Geraffel-Village/Beernary/README

# b33rn4rycounter
B33rn4ry Counter v2 by GeraffelVillage

https://wiki.geraffel-village.de/doku.php?id=geraffel:b33rn4ry

## Hardware V1
* based on a Atmel uC
* written is assembler

## Hardware V2
* based on RaspberryPi
* written in python
* operation separated into 2 functional boxes:
  * counter "counting and accesscontrol" (connected to the draught beer dispenser)
  * registry / cashier (Qt-Gui)
