Geraffel-Village/Beernary/pcb-design/README.md

# b33rn4ryCounter PCB

Printed circuit board for the b33rn4ry counter.

PCB
