Geraffel-Village/Beernary/beernary/interface/deleteUser.png

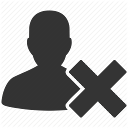
beernary/interface/deleteUser.png
