Geraffel-Village/Beernary/beernary/interface/exit.png

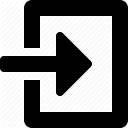
beernary/interface/exit.png
