Geraffel-Village/Beernary/beernary/interface/newUser.png

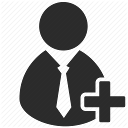
beernary/interface/newUser.png
