Geraffel-Village/Beernary/beernary/interface/refresh.png

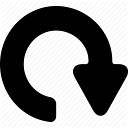
beernary/interface/refresh.png
