Geraffel-Village/Beernary/pcb-design/b33rn4ryCounterPCB.png

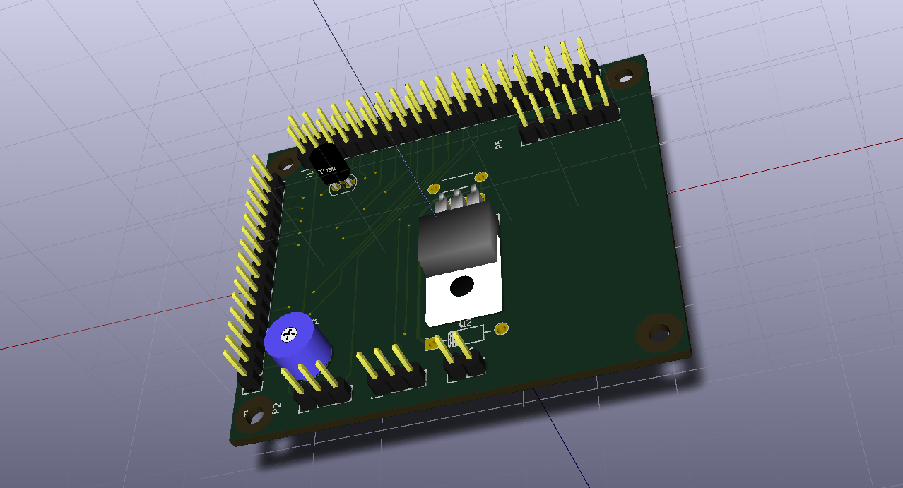
pcb-design/b33rn4ryCounterPCB.png
