Geraffel-Village/Beernary/(threads)

Thread 2 (2015-10-04):

add some local controls of operation

SvenRoederer, 2015-10-04:
Think it would be nice to have some buttons to change the keg without the need of a PC

SvenRoederer, 2019-07-27:
@MicDiFebo is this a feature you referenced by "Kür"?

MicDiFebo, 2019-07-29:
Ack, I was thinking about having a reminiscence to the classical BC, where we had 4 buttons for basic operations directly on the device. That were Up, Down, Enter, Escape/Back. Thats all we need.

SvenRoederer, 2019-07-30:
Do we have such 4-way control? What about an encoder  (turn left, turn right, press button)?

What functions do we want to control?

MicDiFebo, 2019-07-30:
Encoder sounds good - a pushwheel, push = Enter for example. Needs one more back-button.
I have some in my Geraffel-Kiste....:-)

SvenRoederer, 2019-07-30:
We can also use a "back" menuitem or a "longpress" return feature.

SvenRoederer, 2019-07-30:
But I'm really unsure, if we can reliable decode the Encoder and it's operation and in parallel doing reliable counting of pulses (see issue #5).

MicDiFebo, 2019-07-30:
We should do it like in a car where you also (normally) cannot edit the setup-parameters while driving. Meaning that local control elements should be blocked while drafting beer.

SvenRoederer, 2023-08-07:
As an potential alternative to the Encoder I got a Adafruit 12-channel touch-sensor (https://www.adafruit.com/product/1982)

Thread 3 (2015-10-04):

some emergency power-source

SvenRoederer, 2015-10-04:
to get a beer even when there is no mains

MicDiFebo, 2019-07-30:
The first and very simply USV only consists of a battery looped in the powerline. That would keep the BC running for hours, but it is not possible to open the valve with that construction.

SvenRoederer, 2019-07-31:
Not sure if a small solid car-battery is an option for the valve (or 2 6V motorcycle batteries)

MicDiFebo, 2019-07-31:
Surely that will work, but that is much too big for our enclosure. :-)
In General we can think of using a 3cell lipo-battery like it is used in RC-modells (I used this in my Heli- and Quadcopter), but then we need a separat charging-electronic, which is a bit more complex for 3cells, because they must be balanced during charging.

SvenRoederer, 2019-08-01:
at the end, we can just replace the wallwart (isn't it 12V DC) by a external battery, just by repluging. As the Pi will keep running by the mentioned USB-type UPS a short moment w/o external power is fully acceptable.
Something like [this 12V 5Ah-type](https://www.reichelt.de/blei-vlies-akku-12-v-5-ah-wp-5-12e-f2-p202385.html?) might be enough and we can charge by a regular bench supply.

SvenRoederer, 2019-08-01:
We should also keep in mind, that w/o mains, the cooler will not run and only a limited amount of fluid can be drafted "corrrectly". So there is only a limited duration we should be able to draft w/o mains, e.g. 1h / 5l beer.

Thread 5 (2019-07-03):

counting of pluses from flowmeter seems unreliable

SvenRoederer, 2019-07-03:
During the last event I found that the same size kegs have very different total number of counts. This leads to an unusable prediction of the fill-level.

I assume, this is caused by the counting-code of the RPi-software. As far as I remember it's using "poll"-mode for the pulses. It's quite realistic that the pulse-frequency is to high or the gpio-lib to slow. Currently we are using https://pypi.org/project/RPi.GPIO/

Options to fix this:
* find a better library
* use a dedicated counting-circuit

MicDiFebo, 2019-07-14:
Beernary counting should be based on realtime-interrupt-counting like it was on our prototype with an Atmel µC. The pulse frequency of the counting device itselve is not really high - as far as I remember we have 171 pulses per liter. Even if you would leave the tap open for a minute and beer is floating constantly i guess you will only have about 10 liters. That means 1710 pulses/minute or 28,5 Hz - not very high ;-)

SvenRoederer, 2019-07-14:
As of the low frequency the effect of a missing pulse is roughly 6ml, only.
But have a reliable counting again a "realtime-interrupt-counting" seems the best option for now. Adding some µC for this which :
* counts pulses on one end
* talks to the RPi on the other end via serial-port
seems to be enough.

Serial communication should at least have two commands:
* "getcount" - returns the number of counted pulses (unsigned int)
* "resetcount" - resets the counter to 0

Having this installed we can still have the RPi-counting connected on parallel and compare the difference of counted pulses and try to improve the RPi-code

SvenRoederer, 2019-07-20:
As discussed on chat, the serial port of the RPi is planned for the serial RFID reader (see PR #6). So a regular serial (rs232 like) connection is not possible. I see following options:
* adding a 2nd serial port of the RPi (USB <--> serial; probably there is some driver "GPIO <---> rs232" around)
* using RS485 to build a serial-bus with RPi, Reader and Counter-chip)
* finding a I2C or SPI counter chip (I had no luck with this)
* adding an SPI / I2C interface to the counting-controller

SvenRoederer, 2022-07-31:
During MCH2022 I installed a small Arduino to count the pulses in parallel to the RPi. It's connected to the RPi via USB (cable looped out to the external USB-ports) for power and serial-interface.

Thread 14 (2019-08-21):

format of RFID-TagID

SvenRoederer, 2019-08-21:
The USB-reader sends a "^D" as first char of RFID, which is also sent into the database.

> INSERT INTO `users` VALUES
> ('^D03004A789','test','2019-08-15 14:50:43'),('^D2F00BF864','mic','2019-08-15 14:51:18')

SvenRoederer, 2019-08-21:
just checked again:
**USB-reader @ Registry:**
* TagID (printed on Tag 0012550099) is stored in DB as "2F00BF7FD3"
* TagID(printed on Tag 0013252798) is stored in DB as "3800CA38BE"
* TagID(nothing printed on) is stored as "03004A7893"

readding the Tags via B33rn4ryRegistry did not insert them with "^D" prefix ???

ziehmon, 2023-07-19:
Seems resolved via #15

Closed 2023-07-19.

Thread 16 (2019-08-21):

fatal fail when "none" id is in Database

SvenRoederer, 2019-08-21:
@MicDiFebo made it to add the following record into the database:

```
+----------+-------------------+---------------------+
| id       | name              | timestamp           |
+----------+-------------------+---------------------+
| None     | Mic               | 2019-08-21 17:26:25 |
```

this caused a fatal excetion on startup of registry:

> pi@b33rnary-c0unter:/home/b33rnary-c0unt3r/b33rn4rycounter $ ./B33rn4ryRegistry.py
Traceback (most recent call last):
  File "./B33rn4ryRegistry.py", line 200, in <module>
    window.refreshUserTable()
  File "./B33rn4ryRegistry.py", line 68, in refreshUserTable
    pID = str(int(row[0][2:], 16))
ValueError: invalid literal for int() with base 16: 'ne'

Thread 18 (2022-07-29):

transfer repo to new GitHub-organization "Geraffel-Village"

SvenRoederer, 2022-07-29:
During MCH2022 @sp3t3rs created @geraffel-village organization, to allow having a common place for all Geraffel-Village projects.
Can you transfer the ownership of this repo to the organization (Settings-menu --> transfer ownership). This way we can preserve the current Issues, PRs (and wiki-pages).

phl0, 2022-07-29:
Will so.

phl0, 2022-07-29:
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

phl0, 2022-07-29:
Can we safely delete that fork?

SvenRoederer, 2022-07-29:
I moved it beside and will take care of removal then.

phl0, 2022-07-30:
done. Welcome Geraffel

Closed 2022-07-30.

Thread 19 (2022-07-30):

Add systemd service script as init.d replacement

SvenRoederer, 2022-07-30:
during MCH2022 the OS was upgraded to Raspberry Pi OS based on Debian 11 (bullseye).
For optimal support we should include a script to start the b33rn4rycounter as a systemd-service.

ziehmon, 2023-07-22:
Implemented in #23  :heavy_check_mark:

Closed 2023-07-22.

Thread 24 (2023-07-23):

Refactor class capsulation, nesting and interfacing

ziehmon, 2023-07-23:
Currently, the implementation is not fully object-oriented. We're missing full object-based implementation for
  - `beernary_lcd.py`
  - `beernary_configuration.py`

Further more,  `beernary_lcd.py` is required to be abstracted from hardware in case of changes, like implemented in `beernary_database`. This can help handling `LCD_LINES` and `STDOUT`-forwarding too.

Also, `UsbRfid` and `SerialRfid` in `beernary_reader.py` could be implemented via a common object and specific characteristics could be overloaded instead of having to classes.

For all code, modules **and** implementation in `beernary_counter.py` and `beernary_registry.py`, proper encapsulation and reusability needs to be restored.

ziehmon, 2023-08-14:
Implemented via #27

Closed 2023-08-14.

Thread 30 (2023-08-16):

Danke für das Sektfrühstück

Orilcious, 2023-08-16:
... devalidiert mal die test credentials unter deployment/ansible/roles/beernary-database/files/beernary-ccc2023.sql

:upside_down_face:

ziehmon, 2023-08-16:
Danke für den Hinweis, der Tag wurde aus der Datenbank entfernt (`beernary-ccc2023.sql` wird sowieso nicht mehr geupdated, dass war ein initialer Datensatz).

Es ist natürlich bekannt das man RFID tags jederzeit clonen kann. Insofern sei dir dein Freisekt gegönnt - works as designed :)

ziehmon, 2023-08-16:
Und: happy first issue :)

Closed 2023-08-16.
