Geraffel-Village/Beernary/pcb-design/b33rn4ryCounterPCB.kicad_pcb

## KiCad design pcb-design/b33rn4ryCounterPCB.kicad_pcb (2023-08-12)

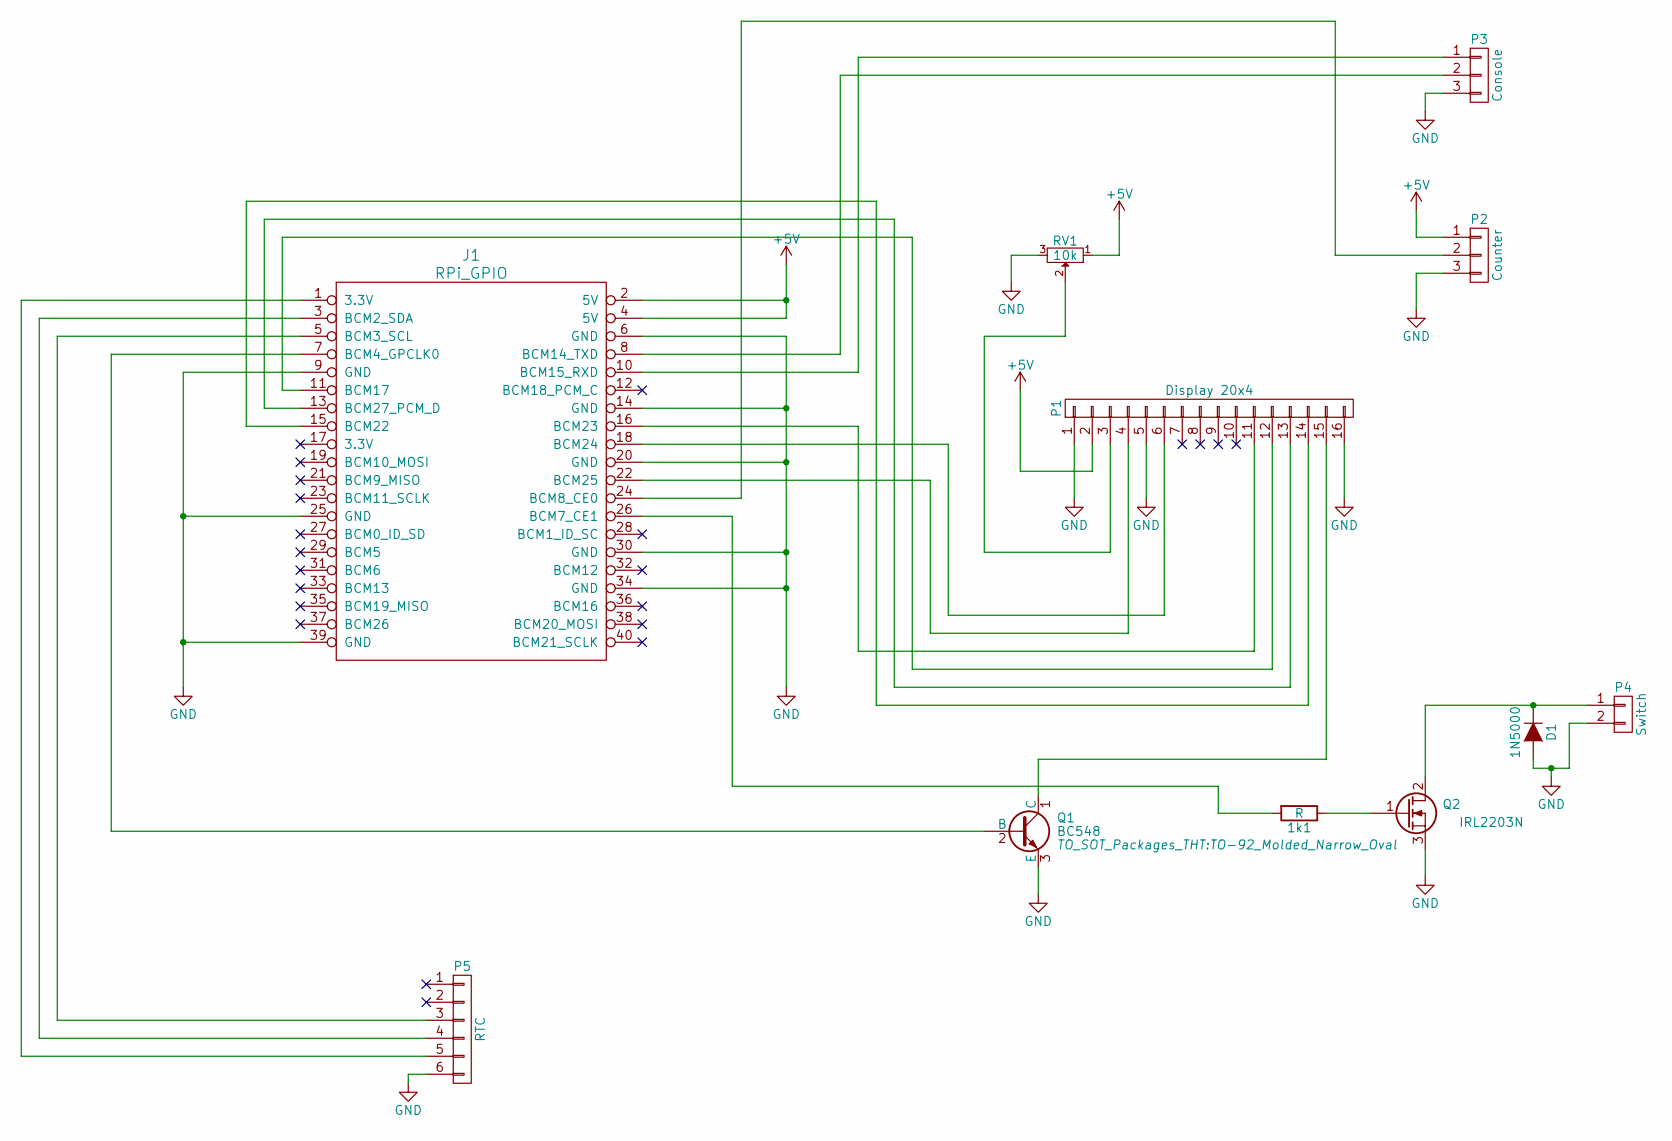
[picture p9: schematic b33rn4ryCounterPCB.sch]

Parts:
1k1: R; Resistor_Horizontal_RM7mm
D1: 1N5000; Diode_DO-41_SOD81_Horizontal_RM10
J1: RPi_GPIO; Pin_Header_Straight_2x20
P1: Display 20x4; Pin_Header_Angled_1x16
P2: Counter; Pin_Header_Straight_1x03
P3: Console; Pin_Header_Straight_1x03
P4: Switch; Pin_Header_Straight_1x02
P5: RTC; Pin_Header_Straight_1x06
Q1: BC548; TO-92_Molded_Narrow_Oval
Q2: IRL2203N; TO-220_Neutral123_Horizontal
RV1: 10k; Potentiometer_Bourns_3339P_Angular_ScrewUp

Connections:
+5V: J1.2 (5V), J1.4 (5V), P1.2, P2.1, RV1.1
GND: D1.2 (A), J1.6 (GND), J1.9 (GND), J1.14 (GND), J1.20 (GND), J1.25 (GND), J1.30 (GND), J1.34 (GND), J1.39 (GND), P1.1, P1.5, P1.16, P2.3, P3.3, P4.2, P5.6, Q1.3 (E), Q2.3 (S), RV1.3
unnamed: 1k1.1, Q2.1 (G)
unnamed: 1k1.2, J1.26 (BCM7_CE1)
unnamed: D1.1 (K), P4.1, Q2.2 (D)
unnamed: J1.1 (3.3V), P5.5
unnamed: J1.3 (BCM2_SDA), P5.4
unnamed: J1.5 (BCM3_SCL), P5.3
unnamed: J1.7 (BCM4_GPCLK0), Q1.2 (B)
unnamed: J1.8 (BCM14_TXD), P3.2
unnamed: J1.10 (BCM15_RXD), P3.1
unnamed: J1.11 (BCM17), P1.12
unnamed: J1.13 (BCM27_PCM_D), P1.13
unnamed: J1.15 (BCM22), P1.14
unnamed: J1.16 (BCM23), P1.11
unnamed: J1.18 (BCM24), P1.6
unnamed: J1.22 (BCM25), P1.4
unnamed: J1.24 (BCM8_CE0), P2.2
unnamed: P1.3, RV1.2
unnamed: P1.15, Q1.1 (C)

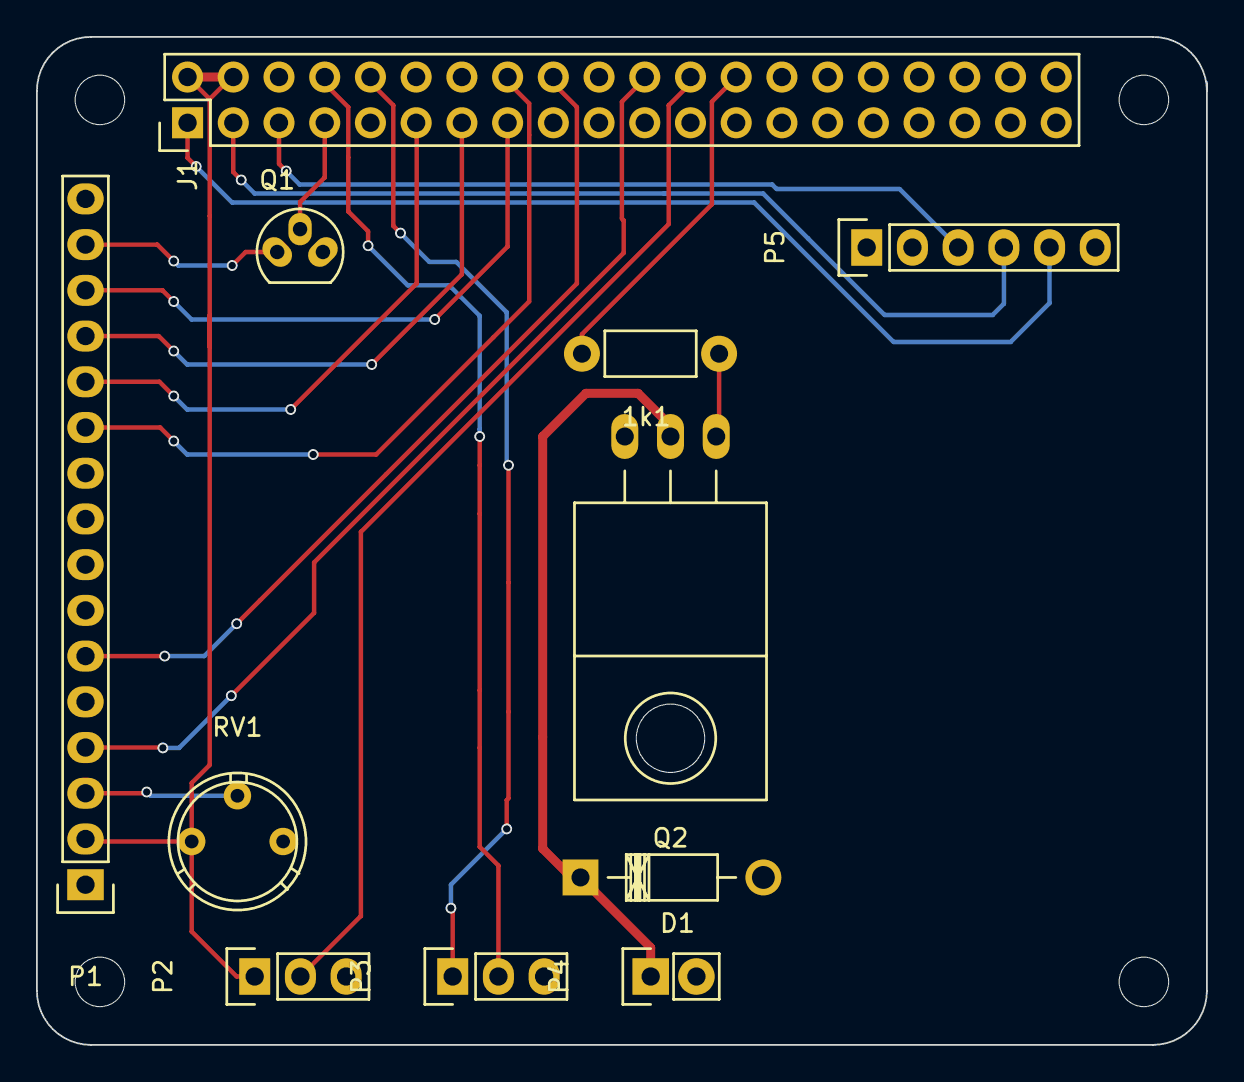
[picture p10: board b33rn4ryCounterPCB.kicad_pcb from above]

Board: 2 copper layers, 65.0 x 56.0 mm, 11 parts (0 on the bottom side), 20 nets.
