Geraffel-Village/Beernary/beernary/beernary_counter.py

#!/usr/bin/python3

"""
This application is for operation of the beernary's registry component
"""

# standard imports
import sys
import configparser
import signal
import random
import threading
import queue

# pip packages
import time
import serial
from loguru import logger

try:
    import RPi.GPIO as GPIO
except: # pylint: disable=bare-except
    import Mock.GPIO as GPIO

# custom beernary
import modules.database
import modules.metrics
import modules.display
import modules.flowsensor
import modules.reader
import modules.valve
import modules.light

auth_queue = queue.Queue()
tap_free = threading.Event()
tap_free.clear()

CONFIG_FILE_PATH    = "/etc/beernary/config.ini"

def main():

    def panic_shutdown(exception):
        """Exit function called by exception handler for clean rundown"""

        GPIO.cleanup()
        if webhook_enabled:
            webhook_reader.close()

        logger.critical(f"System shutdown initiated via exception: {exception}")
        raise(exception)


    def graceful_shutdown(signalnumber, stackframe):

        signal_light.send_command(signal_light.GREEN_OFF)
        signal_light.send_command(signal_light.RED_OFF)
        signal_light.send_command(signal_light.YELLOW_OFF)
        signal_light.send_command(signal_light.RED_BLINK)

        if webhook_enabled:
            webhook_reader.close()

        rfid_reader.close()
        display.close()
        flowsensor.close()
        valve.close()

        logger.critical("System shutdown initiated via SIGINT")
        sys.exit(0)

    signal.signal(signal.SIGTERM, graceful_shutdown)

    try:

        # Configuration handling
        config                 = configparser.ConfigParser(allow_no_value=True)
        config.read(CONFIG_FILE_PATH)

        log_level                   = config.get("system",                  "log_level")

        mysql_host                  = config.get("mysql",                   "hostname")
        mysql_user                  = config.get("mysql",                   "username")
        mysql_password              = config.get("mysql",                   "password")
        mysql_database              = config.get("mysql",                   "database")
        mock_devices_enabled        = eval(config.get("system",             "mock_devices_enabled"))

        metrics_enabled            = eval(config.get("metrics",             "enabled"))

        influxdb_host                = config.get("influxdb",               "host")
        influxdb_port                = config.get("influxdb",               "port")
        influxdb_username            = config.get("influxdb",               "username")
        influxdb_password            = config.get("influxdb",               "password")
        influxdb_database            = config.get("influxdb",               "database")

        signal_light_device         = config.get("serial_devices",          "signal_light")

        rfid_serial_device          = config.get("serial_devices",          "rfid_reader")
        gpio_pin_flowsensor         = int(config.get("gpio_pins",           "flowsensor"))
        gpio_pin_valve              = int(config.get("gpio_pins",           "valve"))

        gpio_pin_valve_2_enabled    = eval(config.get("gpio_pins",          "valve_2_enabled"))
        gpio_pin_valve_2            = int(config.get("gpio_pins",           "valve_2"))

        draft_time_unlock           = int(config.get("draft",               "time_unlock"))
        draft_time_warning          = int(config.get("draft",               "time_warning"))

        webhook_enabled             = eval(config.get("identity_webhook",    "enabled"))
        webhook_port                = int(config.get("identity_webhook",     "port"))
        webhook_token               = config.get("identity_webhook",     "token")

        #  Local variables
        current_user_id         = ""
        current_user_pulses_stx = int   # pulses before draft
        current_user_pulses_etx = int   # pulses after draft

        current_keg_id          = int
        previous_keg_id         = current_keg_id

        event_id                = None
        event_name              = None

        # Initialize logging
        logger.remove(0)                        # remote default logger
        logger.add(sys.stdout, level=log_level, colorize=True)     # add handler with custom log level
        logger.add("./log/beernary-counter.log", level=log_level, colorize=True)     # add handler with custom log level

        if webhook_enabled:
            logger.info("Try to start webhook")
            webhook_reader      = modules.reader.HTTPReader(webhook_port, webhook_token)

        # Initalize LCD display
        global display
        display                 = modules.display.LCDDisplay()
        display.enabled         = True  # enable backlight

        # Initalize signal light
        global signal_light

        if mock_devices_enabled == True:
            signal_light = modules.light.BeernarySignalLightMock(None, None)
        else:
            signal_light = modules.light.BeernarySignalLight(signal_light_device, 9600)
        signal_light.send_command(signal_light.GREEN_OFF)
        signal_light.send_command(signal_light.RED_OFF)
        signal_light.send_command(signal_light.RED_ON)

        # Initialize valve
        global valve
        valve                   = modules.valve.Valve(gpio_pin_valve)

        # Initialize valve 2
        if gpio_pin_valve_2_enabled == True:
            valve_2             = modules.valve.Valve(gpio_pin_valve_2)

        # Initalize flowsensor
        if mock_devices_enabled == True:
            flowsensor = modules.flowsensor.PulseFlowsensorMock(None)
        else:
            flowsensor = modules.flowsensor.PulseFlowsensor(gpio_pin_flowsensor)

        # Reader initialization
        if mock_devices_enabled == True:
            rfid_reader = modules.reader.MockRfidReader(None, None)
        else:
            try:
                rfid_reader = modules.reader.RawRfidReader(rfid_serial_device, 9600)

            except serial.serialutil.SerialException:
                logger.critical(f"Could not open serial device: {rfid_serial_device}")
                display.send_message("[E] Serial setup error", 2 ,"ljust")
                sys.exit(1)

            else:
                logger.info(f"Successfully opened serial device: {rfid_serial_device}")

        # Database initialization
        try:
            database   = modules.database.BeernaryMysqlTransaction(host=mysql_host,
                                                                   user=mysql_user,
                                                                   passwd=mysql_password,
                                                                   database=mysql_database)

        except Exception as exception:
            logger.critical(f"Could not open database : {exception}")
            display.send_message("[E] Database failed",2,"ljust")
            sys.exit(1)

        else:
            logger.info(f"Successfully opened database: {mysql_database} at {mysql_host}")

        # InfluxDB initialization
        try:
            metricsClient = modules.metrics.BeernaryInfluxDBClient(influxdb_host, influxdb_port, influxdb_username, influxdb_password, influxdb_database)

        except Exception as exception:
            logger.critical(f"Could not connect to InfluxDB {exception}")
            display.send_message("[E] InfluxDB failed",2,"ljust")
            sys.exit(1)

        else:
            logger.info(f"Successfully started InfluxDB connection to server: {influxdb_host}")

        # Event initialization
        try:
            event_data  = database.get_active_event()
            event_id    = event_data[0]
            event_name  = event_data[1]

        except modules.database.BeernaryTransactionLogicError as exception:
            logger.critical(f"Could not open active event: {exception}")
            display.send_message("[E] Event setup error",2,"ljust")
            sys.exit(1)

        else:
            logger.info(f"Successfully received active event: {event_name}")

        # Keg initialization
        try:
            current_keg_id      = database.get_current_keg(event_id)         # initialize keg ID as in database      pylint: disable=line-too-long
            current_keg_pulses  = database.get_keg_pulses(current_keg_id)    # initialize keg pulses as in databse   pylint: disable=line-too-long
            previous_keg_id     = current_keg_id                             # set initial rotation state            pylint: disable=line-too-long

        except modules.database.BeernaryTransactionLogicError as exception:
            logger.critical(f"Could not get active keg: {exception}")
            display.send_message("[E] Keg setup error ",2,"centred")
            sys.exit(1)

        else:
            logger.info(f"Successfully received active keg: {current_keg_id}")

        # --- Start the threads before the main loop ---
        def webhook_auth_task():
                while True:
                    current_user_id = webhook_reader.read_rfid()
                    if not tap_free.is_set():
                        logger.warning("Tap is currently busy, skipping webhook auth")
                        time.sleep(1)
                        continue
                    if current_user_id is not None:
                        logger.info(f"Webhook identity received: {current_user_id}")
                        auth_queue.put({
                            "source": "webhook",
                            "user_id": current_user_id,
                            "user_name": current_user_id,
                            "user_tap": 1
                        })
                        logger.info("Pushed webhook auth to queue")
                    time.sleep(1)

        def rfid_auth_task():
            while True:
                rfid_reader.flush_queue()
                current_user_id = rfid_reader.read_rfid()
                if not tap_free.is_set():
                    logger.warning("Tap is currently busy, skipping RFID auth")
                    continue
                if current_user_id is not None:
                    logger.info(f"Received RFID tag: {current_user_id}")
                    current_user_data = database.check_user(current_user_id)
                    if current_user_data:
                        logger.info("Pushing RFID auth to queue")
                        auth_queue.put({
                            "source": "rfid",
                            "user_id": current_user_id,
                            "user_name": current_user_data[0],
                            "user_tap": int(current_user_data[1])
                        })
                        logger.info("Pushed RFID auth to queue")
                time.sleep(0.1)

        # Start auth threads
        webhook_thread = None
        if webhook_enabled:
            webhook_thread = threading.Thread(target=webhook_auth_task, daemon=True)
            webhook_thread.start()
            
        rfid_thread = threading.Thread(target=rfid_auth_task, daemon=True)
        rfid_thread.start()


        logger.info("Beernary successfully initialized! Welcome home.")

        # Bootscreen
        display.send_message("  Beernary Counter  ",      1,"ljust")
        display.send_message("                    ",      2,"ljust")
        display.send_message("     Welcome to     ",      3,"ljust")
        display.send_message(event_name, 4,"centred")
        time.sleep(2)

        valve.unlocked  = False

        # Main application loop
        while True:

            # Handle keg rotation
            try:
                current_keg_id = database.get_current_keg(event_id)

                # detect rotated keg
                if previous_keg_id != current_keg_id:                               # detect rotation in database based on keg ID               pylint: disable=line-too-long

                    current_keg_pulses = database.get_keg_pulses(current_keg_id)    # set pulses for current keg as in database for new keg     pylint: disable=line-too-long

                    logger.info(f"Successfully rotated keg {previous_keg_id} to {current_keg_id}")

                    previous_keg_id    = current_keg_id                             # finish rotation by adjusting keg ID                       pylint: disable=line-too-long

            except modules.database.BeernaryTransactionLogicError as exception:
                logger.critical(f"Could not get active keg: {exception}")
                display.send_message("[E] Keg setup error ", 2, 1)
                sys.exit(1)

            signal_light.send_command(signal_light.RED_ON)

            display.clear()
            display.send_message("  Beernary Counter  ",1,"ljust")
            display.send_message("                    ",2,"ljust")
            display.send_message("   Please scan tag  ",3,"ljust")
            display.send_message("                    ",4,"ljust")

            # --- Replace the main loop's auth check with this ---
            tap_free.set()  # Tap is free, allow auth tasks to yield identities
            logger.info("Awaiting auth from thread queue")
            current_user = auth_queue.get()  # This will block until something is in the queue
            tap_free.clear()  # Tap is now busy, lock out auth tasks

            current_user_id = current_user["user_id"]
            current_user_name = current_user["user_name"]
            current_user_tap = current_user["user_tap"]

            if current_user_name is not None and current_user_tap is not None:
                current_user_data = (current_user_name, current_user_tap)
            else:
                current_user_data = None

            display.enabled = True

            # Implicit check for unauthorized user
            if current_user_data is not None:

                signal_light.send_command(signal_light.RED_OFF)
                signal_light.send_command(signal_light.GREEN_BLINK)

                logger.info(f"Authorized user {current_user_name} for Tap {current_user_tap}")

                display.send_message(f"User {current_user_name}", 3, "ljust")
                display.send_message(f"Draft from tap {current_user_tap}", 4, "ljust")
                time.sleep(1)

                # "Map" start pulse count to user context
                current_user_pulses_stx = flowsensor.pulses
                logger.debug(f"STX pulse value for {current_user_name}: {current_user_pulses_stx}")

                if current_user_tap == 1:
                    logger.debug("Set output valve to main valve")
                    tap_valve = valve
                elif current_user_tap == 2 and gpio_pin_valve_2_enabled:
                    logger.debug("Set output valve to secondary valve")
                    tap_valve = valve_2
                else:
                    raise(modules.database.BeernaryTransactionLogicError(f"Invalid tap ID: {current_user_tap} with type {type(current_user_tap)}"))

                tap_valve.unlocked = True

                for i in range (draft_time_unlock):
                    time.sleep(1)
                    display.send_message(f"Draft time left: {draft_time_unlock-i}s",   4, "ljust")

                    if i >= draft_time_warning:
                        signal_light.send_command(signal_light.GREEN_OFF)
                        signal_light.send_command(signal_light.GREEN_OFF)
                        signal_light.send_command(signal_light.YELLOW_BLINK)
                    if mock_devices_enabled is True:
                        flowsensor.add_pulse(random.randint(1,10))

                tap_valve.unlocked = False

                # "Map" stop pulse count to user context
                current_user_pulses_etx = flowsensor.pulses
                current_user_pulses = current_user_pulses_etx - current_user_pulses_stx
                current_keg_pulses  = current_keg_pulses + current_user_pulses
                logger.debug(f"ETX pulse value for {current_user_name}: {current_user_pulses}")

                try:
                    database.store_draft(current_user_id, current_user_pulses)
                    database.set_keg_pulses(current_keg_id, current_keg_pulses)

                    if metrics_enabled:
                        metricsClient.push_draft(current_user_tap, current_user_id, current_user_name, current_user_pulses)

                except modules.database.BeernaryTransactionLogicError as exception:
                    logger.critical(f"Could not store draft: {exception}")
                    sys.exit(1)

                signal_light.send_command(signal_light.YELLOW_OFF)

            # Handling of unauthorized user
            elif current_user_data is None:

                logger.warning(f"Unauthorized user: {current_user_id}")

                signal_light.send_command(signal_light.RED_OFF)
                signal_light.send_command(signal_light.RED_BLINK)

                display.send_message("Unauthorized access!",   3, "ljust")
                display.send_message("Staff is informed",      4, "ljust")

                signal_light.send_command(signal_light.BUZZER_ON)
                time.sleep(0.2)
                signal_light.send_command(signal_light.BUZZER_OFF)
                time.sleep(0.2)
                signal_light.send_command(signal_light.BUZZER_ON)
                time.sleep(0.2)
                signal_light.send_command(signal_light.BUZZER_OFF)
                time.sleep(2)
                signal_light.send_command(signal_light.RED_OFF)

            rfid_reader.flush_queue()

    except Exception as exception:
        panic_shutdown(exception)

if __name__ == '__main__':
    main()
