Geraffel-Village/Beernary/deployment/ansible/group_vars/production/main.yml

# code: language=ansible
---
beernary_database_sql_files:
  - "beernary-schema.sql"
beernary_counter_config_mysql_hostname: "127.0.0.1"
beernary_counter_config_mysql_username: "beernary"
beernary_counter_config_mysql_password: !vault |
          $ANSIBLE_VAULT;1.1;AES256
          30613765393630343334636638633332353364656366616366656463623663326662343433663063
          3236373933393436633939656335316163323239623935390a323332663239326465386337383339
          63366438396264643939646364343239316530393237383264316362393530333366643365313433
          6366396266396261370a343539663534613731616434333432653635383632666432643236333162
          31346164396337343465373265366363626333353636303564626134323562303631
beernary_counter_config_mysql_database: "beernary"
beernary_counter_config_serial_rfid_reader: "/dev/ttyS0"
beernary_counter_config_serial_signal_light: "/dev/serial/by-id/usb-1a86_USB_Serial-if00-port0"
beernary_counter_config_serial_arduino: "/dev/serial/by-id/usb-Silicon_Labs_CP2104_USB_to_UART_Bridge_Controller_0247A948-if00-port0"
beernary_counter_config_gpio_valve: 6
beernary_counter_config_gpio_flowsensor: 5
beernary_counter_config_gpio_valve_2: 12
beernary_counter_config_gpio_valve_2_enabled: true
beernary_counter_config_draft_time_unlock: 20
beernary_counter_config_draft_time_warning: 15
beernary_counter_config_identiy_webhook_token: "abc"
beernary_counter_config_metrics_enabled: "True"
beernary_database_root_password: !vault |
          $ANSIBLE_VAULT;1.1;AES256
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
          6666623565646361660a386162326161346462393062336136613535663332336431623262383761
          39303961653766396538306333643364363665376164363664313132316566306235646132656531
          6339323033663133663232336133626265316362643966376364
