Geraffel-Village/Beernary/deployment/ansible/group_vars/testing/main.yml

# code: language=ansible
---

ansible_become: true

beernary_database_sql_files:
  - "beernary-schema.sql"
  - "beernary-data.sql"
beernary_counter_config_mysql_hostname: "127.0.0.1"
beernary_counter_config_mysql_username: "root"
beernary_counter_config_mysql_password: "changeme"
beernary_counter_config_mysql_database: "beernary"
beernary_counter_config_mock_devices_enabled: true
beernary_counter_config_serial_rfid_reader: "/dev/ttyS0"
beernary_counter_config_serial_signal_light: "/dev/serial/by-id/usb-1a86_USB_Serial-if00-port0"
beernary_counter_config_serial_arduino: "/dev/serial/by-id/usb-1a86_USB_Serial-if00-port0"
beernary_counter_config_gpio_valve: 6
beernary_counter_config_gpio_valve_2: 7
beernary_counter_config_gpio_valve_2_enabled: false
beernary_counter_config_gpio_flowsensor: 5
beernary_counter_config_draft_time_unlock: 20
beernary_counter_config_draft_time_warning: 5
beernary_database_root_password: "changeme"
beernary_database_password: "changeme"
os_configuration_apt_upgrade: false

beernary_influxdb_username: "beernary"
beernary_influxdb_password: "d6fb9d6da093d2419c61ae1c37783822"
beernary_influxdb_database: "beernary-test"
beernary_influxdb_loglevel: "info"
beernary_influxdb_enable_http_log: "true"
beernary_influxdb_http_host: 127.0.0.1
beernary_influxdb_http_port: 8086

beernary_grafana_admin_password: "d6fb9d6da093d2419c61ae1c37783822"
