Geraffel-Village/Beernary/(commit log)

2015-08-12 added basic prototype to react on pulses from flowmeter
2015-08-12 new class "BeerKeg" to handle the Keg - a pulse from sensor will trigger the "BeerKeg.newPulse()"-member - when user logs in the variable "IdPulsesStart" will change from None to pulses counted for t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
2015-08-13 removed 300 debounce -setting on flowsensor input - checked for function by BusPirate swtiching and Mics-impulse-rotary-switch
2015-08-13 FIX: when switching to "IDLE" also calculate volume
2015-08-13 switching to "MYSQL"-database on production-BC
2015-08-13 the pulldown for the flowsensor is installed in connector-hardware, so disabling it in SoC
2015-08-13 added database.getKegPulses() & database.setKegPulses to be able to count on the whole keg - current Keg-pulses will be stored at every end of a draft-process
2015-08-14 added tab to select the event you work on in Servicemenu - selected eventid is stored in "window.currentEvent"
2015-08-14 added Event-detection & Keg-detection to B33rn4ryCounter - also print message on display in case of error
2019-08-21 B33rn4ryCounter: read serial-device from config-file
2019-08-21 Registry: refactor reading of serial-device
    move reading of configuration into main() and push settings
    (database, device for reader) into the classes as needed.
2019-08-21 B33rn4ryDatabase: do not fail on adding 1st keg of an event
    current code was failing, because on a new event will be no keg
    to be marked as empty. So do not raise an error when there is no
    keg defined.
2023-08-06 counter-board: add Arduino-code for hardware-level pulse-counting
    We are not sure, if the RPi will count the pulses fast enough or lose some,
    So there is an additional Arduino hooked up in parallel to do this.
    We use a "Metro mini" (Atmega328 16MHz), connected via its build-in USB.
2023-08-12 Commit v2.1 initial (#23)
    [RPi_GPIO.sch, b33rn4ryCounterPCB.kicad_pcb, b33rn4ryCounterPCB.sch]
2023-08-16 Add second valve implementation (#29)
    * Add seconds valve implementation
    * PROD customizing
    ---------
2023-08-16 Fix shutdown routine (#32)
    [beernary_counter.py]
2023-08-16 Add local RFID reader tool (#33)
    * Fix exception for shutdown
    * Add new tool to read RFID
    * Fix USB reader implementation
    * Decrease restart time
    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
    [beernary_counter.py, beernary_reader.py, reader.py]
2023-08-16 Fix SIGTERM handler (#36)
    [beernary_counter.py]
2023-08-17 Add metrics collection with InfluxDB (#34)
    * Add metrics collection with InfluxDB
    * Fix missing tap in metrics push call
    * Fix log message
    * Downgrade to influxdb 1.8
    As 2.0 does not run on 32 bits hardware
    [beernary_counter.py, database.py, main.yml, metrics.py]
2023-08-17 Implement mocking of classes for physical devices (#37)
    So that we can run the code without any special hardware
2023-08-17 Fix InfluxDB escaping (#41)
    [metrics.py]
2023-08-17 Implement mocking of classes for physical devices
    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
2023-08-17 Fix config parsing and reader initialization (#43)
    [beernary_counter.py, reader.py]
2023-08-17 Fix grafana bootstrapping
    Service grafana-server was not started
    [main.yml]
2023-08-17 Fix webhook shutdown (#45)
    [beernary_counter.py, display.py, flowsensor.py, main.yml, reader.py, valve.py]
2023-08-17 Second try to fix grafana bootstrapping (#46)
    [main.yml]
2025-08-09 Attempt to fix display timing issues
    [display.py]
2025-08-09 Avoid D6 (GPIO 27) for display. Temporary workaround to bisect issues.
    [display.py]
2025-08-09 fix signal light LED color mapping to be more intuitive
    [beernary_counter.py]
2025-08-09 support webhook auth w/ threads
2025-08-11 Remove display threading lock
2025-08-11 Add sleep in webhook auth, avoiding the method to be called too frequently
    [beernary_counter.py]
